sensorable/g935-electronics/pwr-conn/g935f-pwr.kicad_pcb

## KiCad design pwr-conn/g935f-pwr.kicad_pcb (2019-05-17)

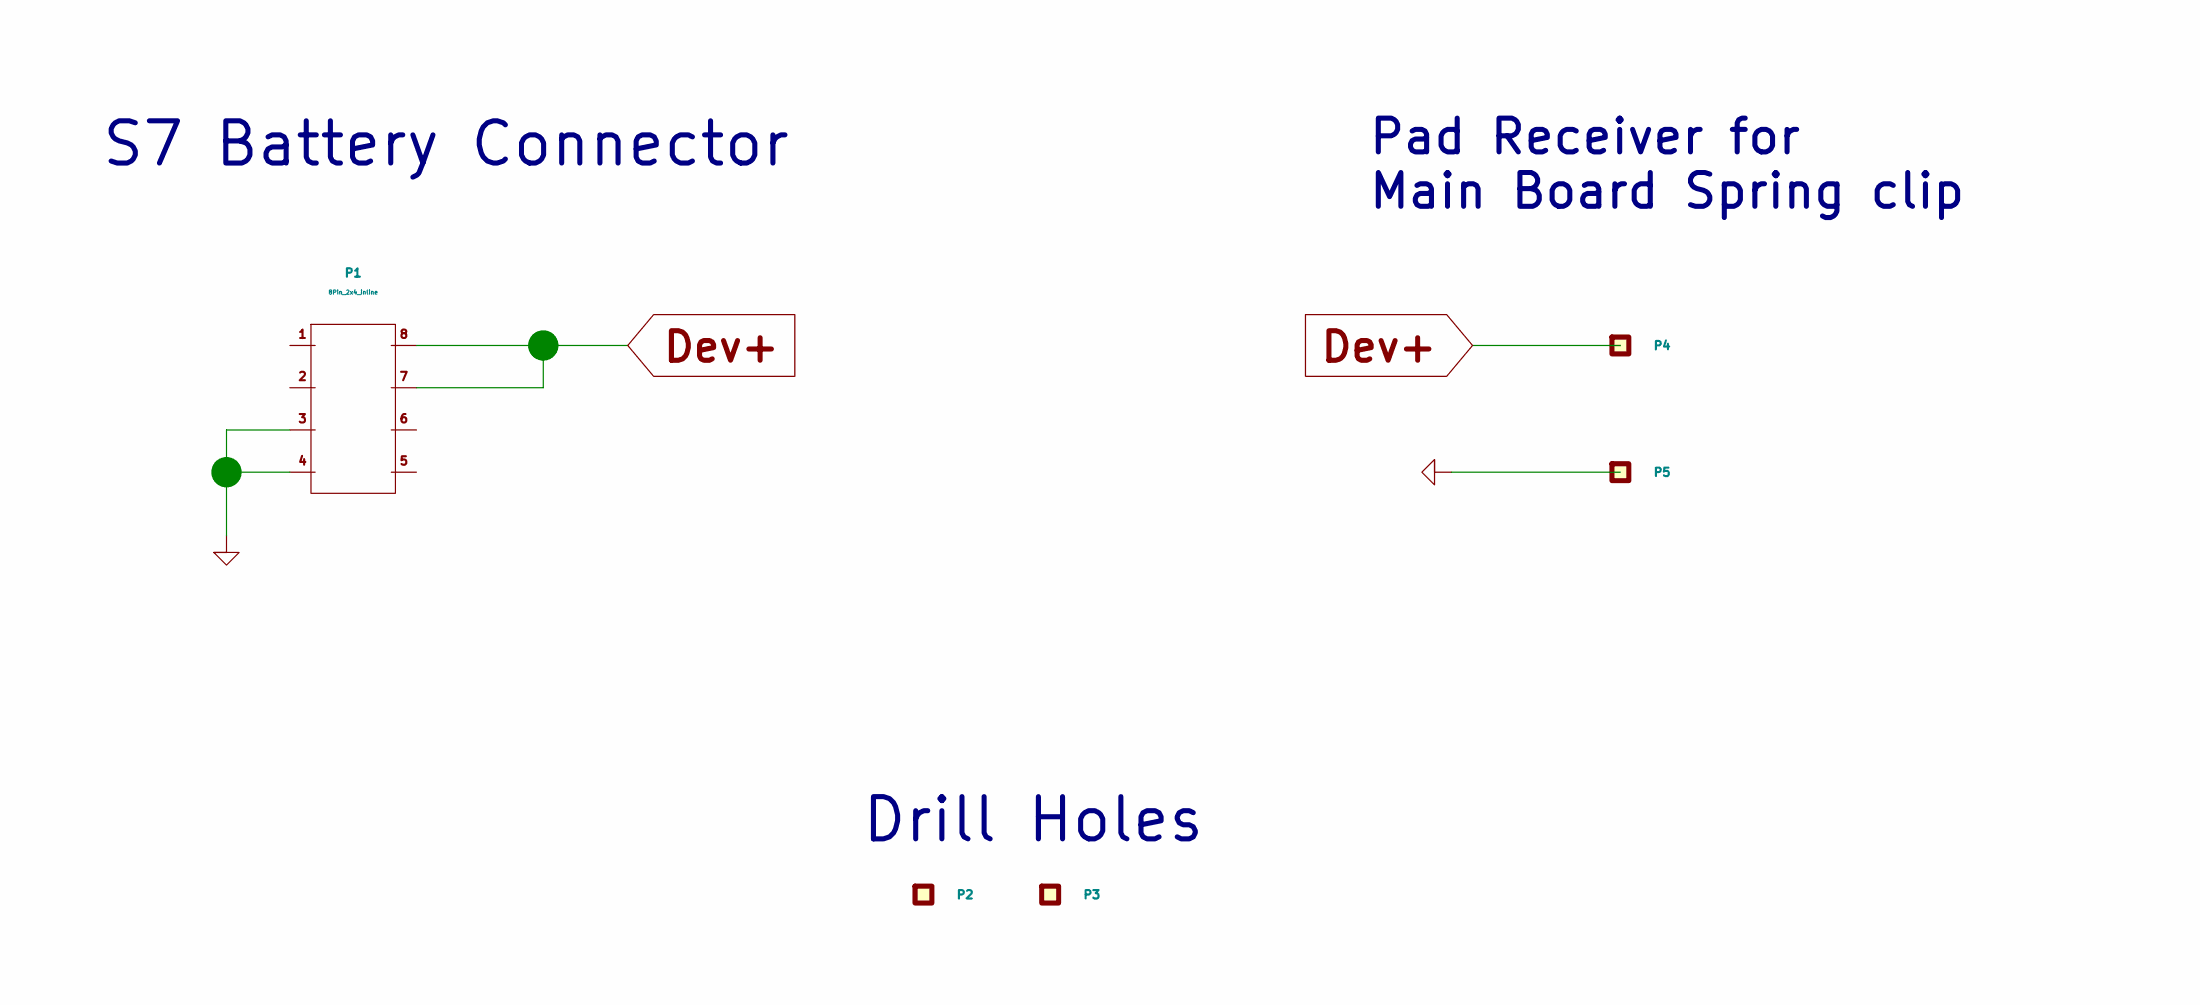
[picture p2: schematic g935f-pwr.sch]

Parts:
P1: 8Pin_2x4_inline; 8pin_molex_s7BatteryConn_5050040810; Manufacturer1PartNumber 5050040810
P2, P3: PAD; NPTH_1.5mm; Manufacturer1PartNumber MFG1PN
P4, P5: PAD; PAD_2.1mm_circle; Manufacturer1PartNumber MFG1PN

Connections:
Dev+: P1.7, P1.8, P4.1
GND1: P1.3, P1.4, P5.1

Notes on the sheet:
S7 Battery Connector
Drill Holes
Pad Receiver for Main Board Spring clip

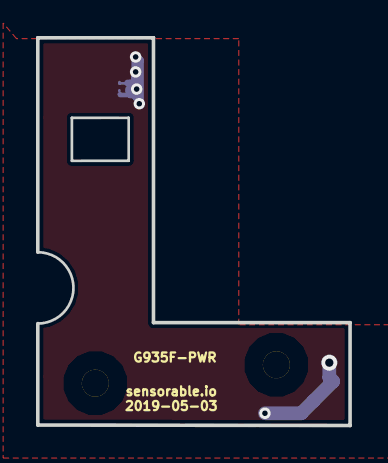
[picture p3: board g935f-pwr.kicad_pcb from above]

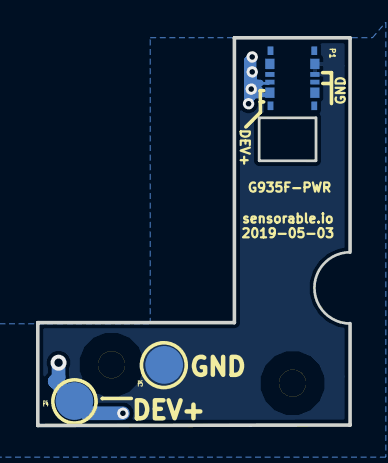
[picture p4: board g935f-pwr.kicad_pcb from below]

Board: 2 copper layers, 17.3 x 21.5 mm, 5 parts (3 on the bottom side), 2 nets.
