sensorable/g935-electronics/psu/g935f-psu.kicad_pcb

## KiCad design psu/g935f-psu.kicad_pcb (2019-05-03)

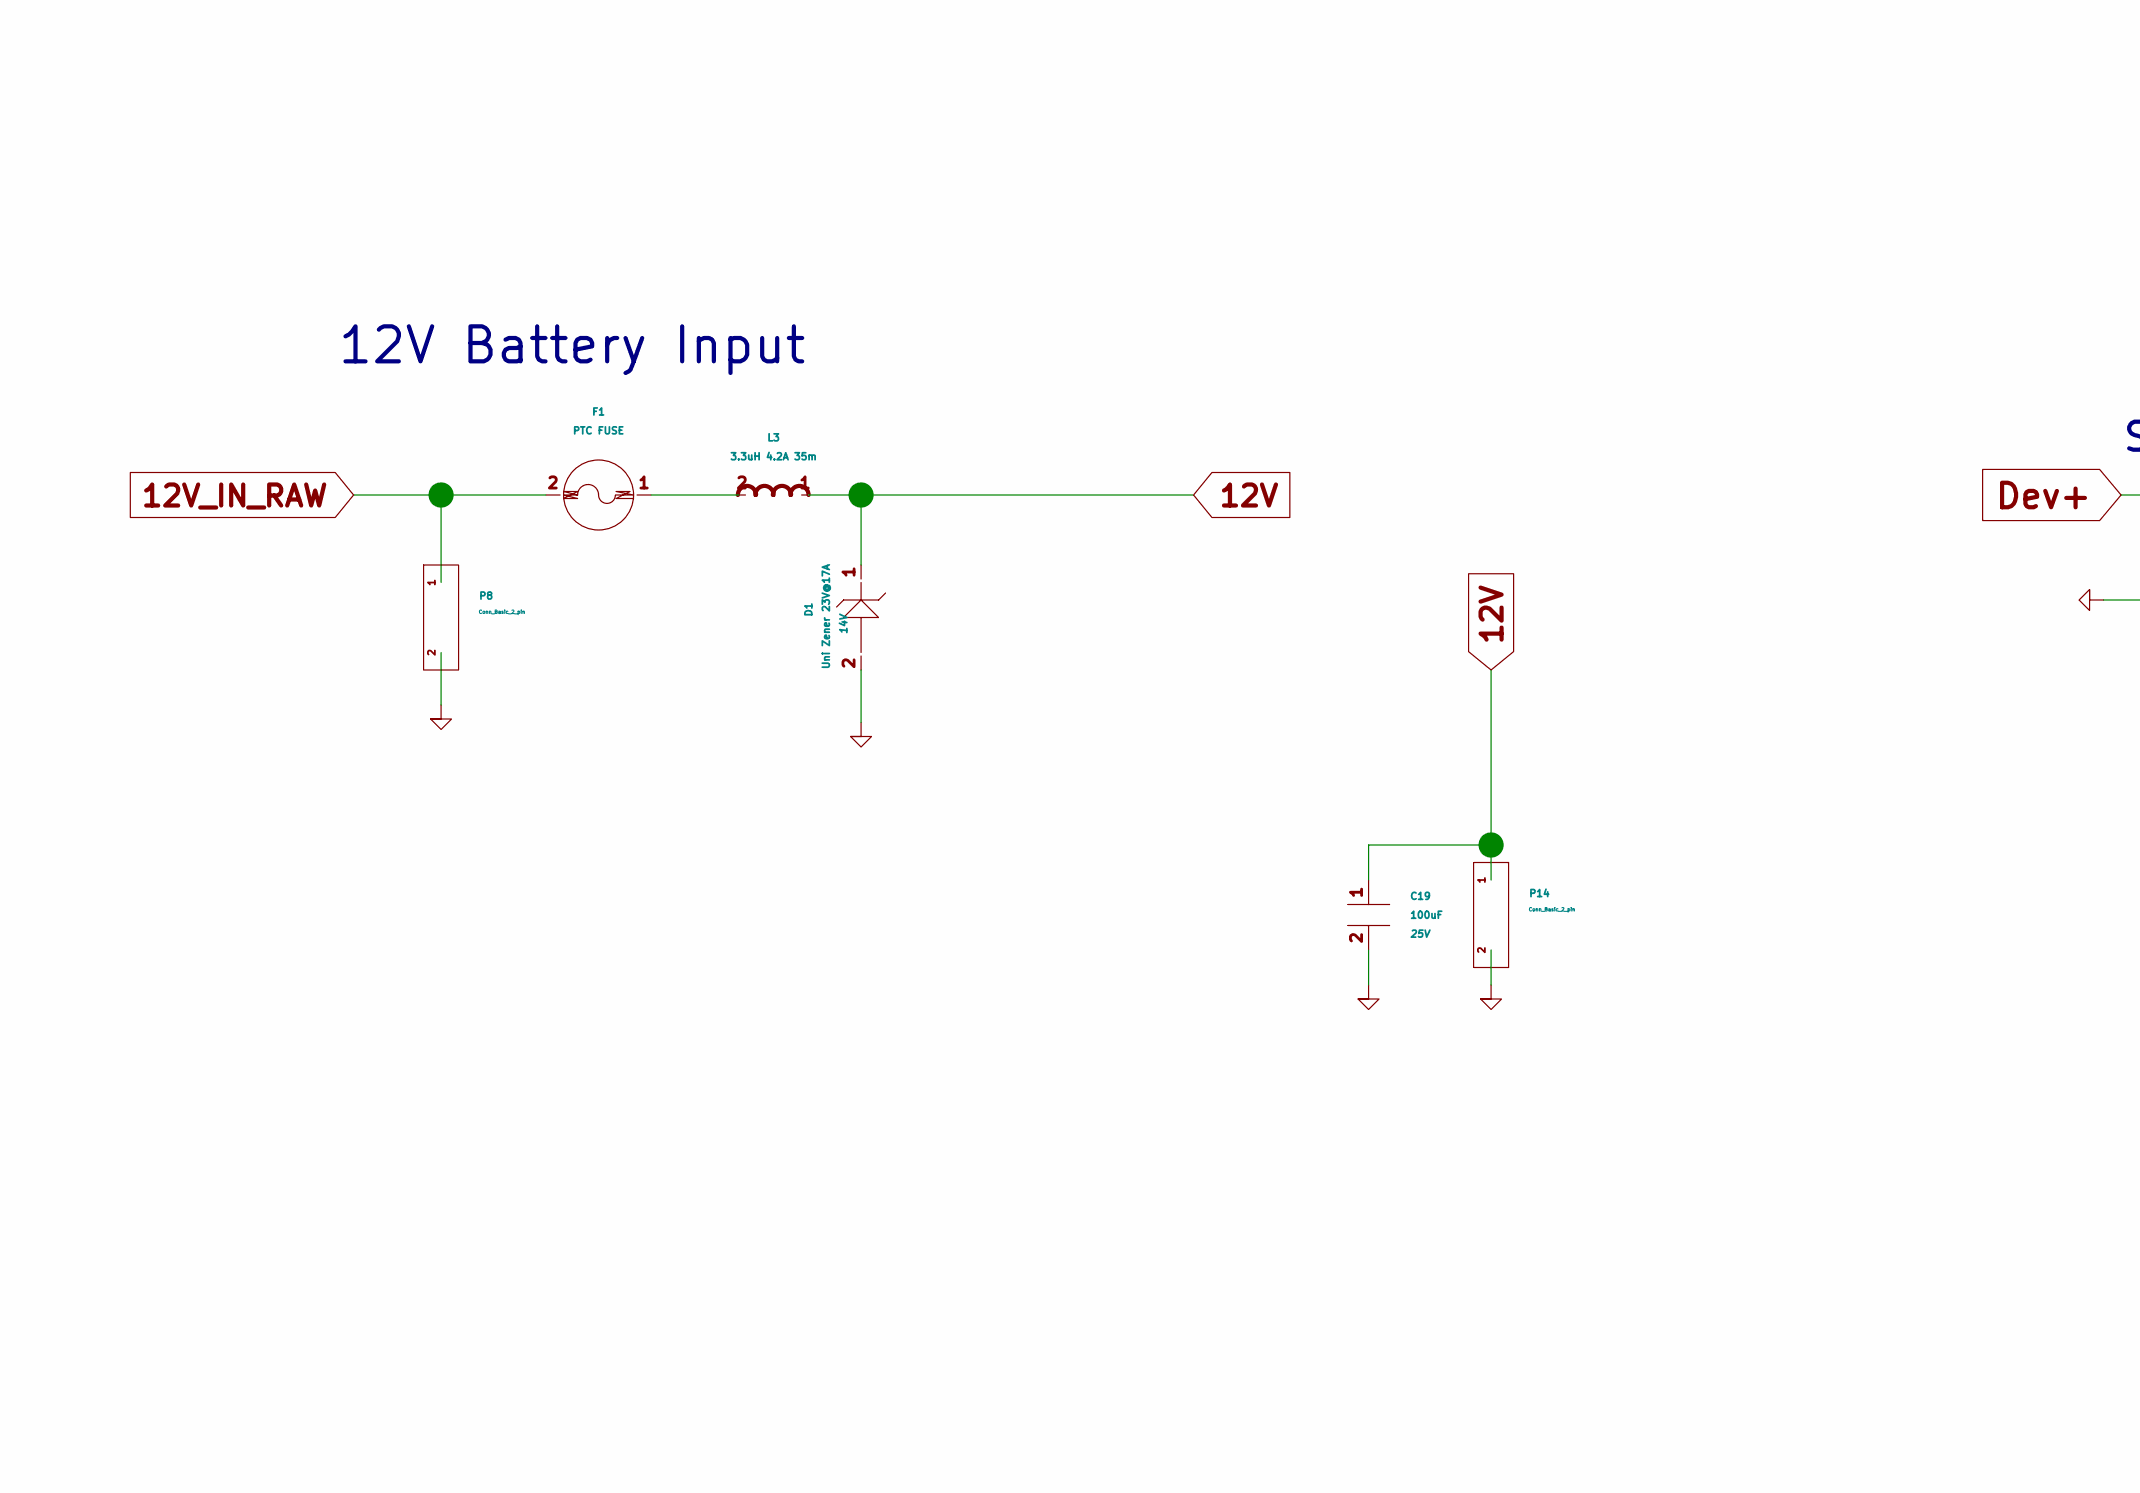
[picture p5: schematic g935f-psu.sch, TrafMaster, part in row 1, column 1]

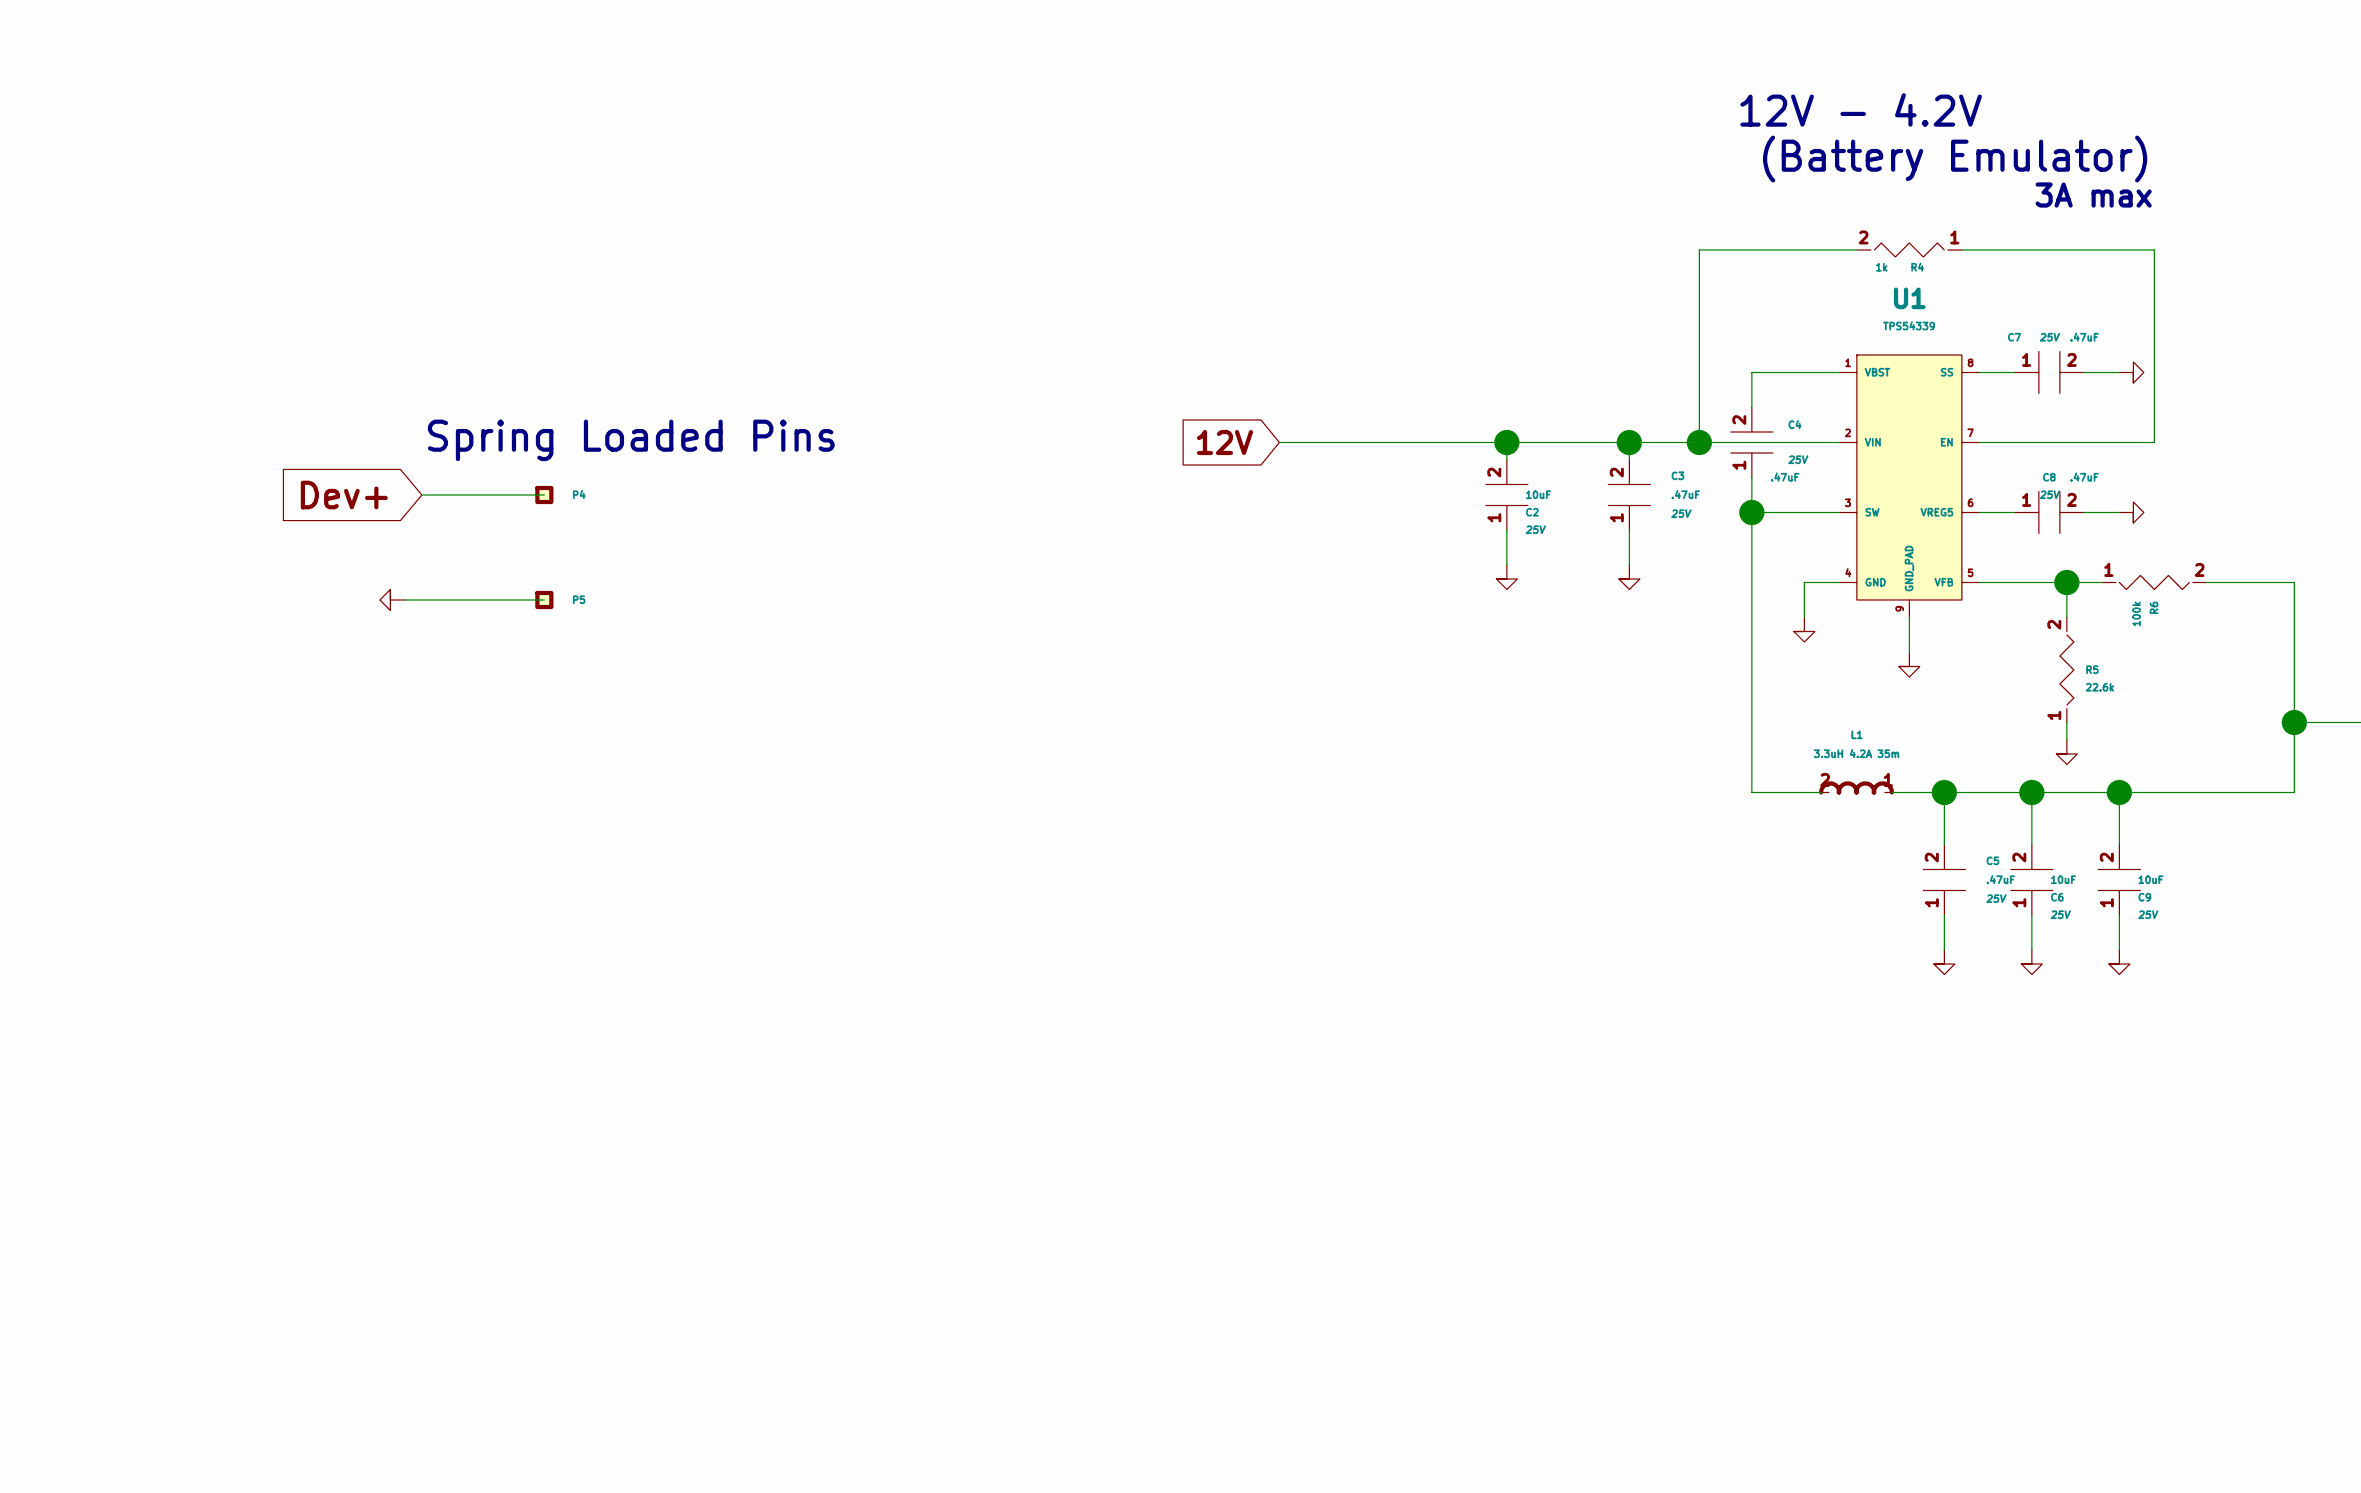
[picture p6: schematic g935f-psu.sch, TrafMaster, part in row 1, column 2]

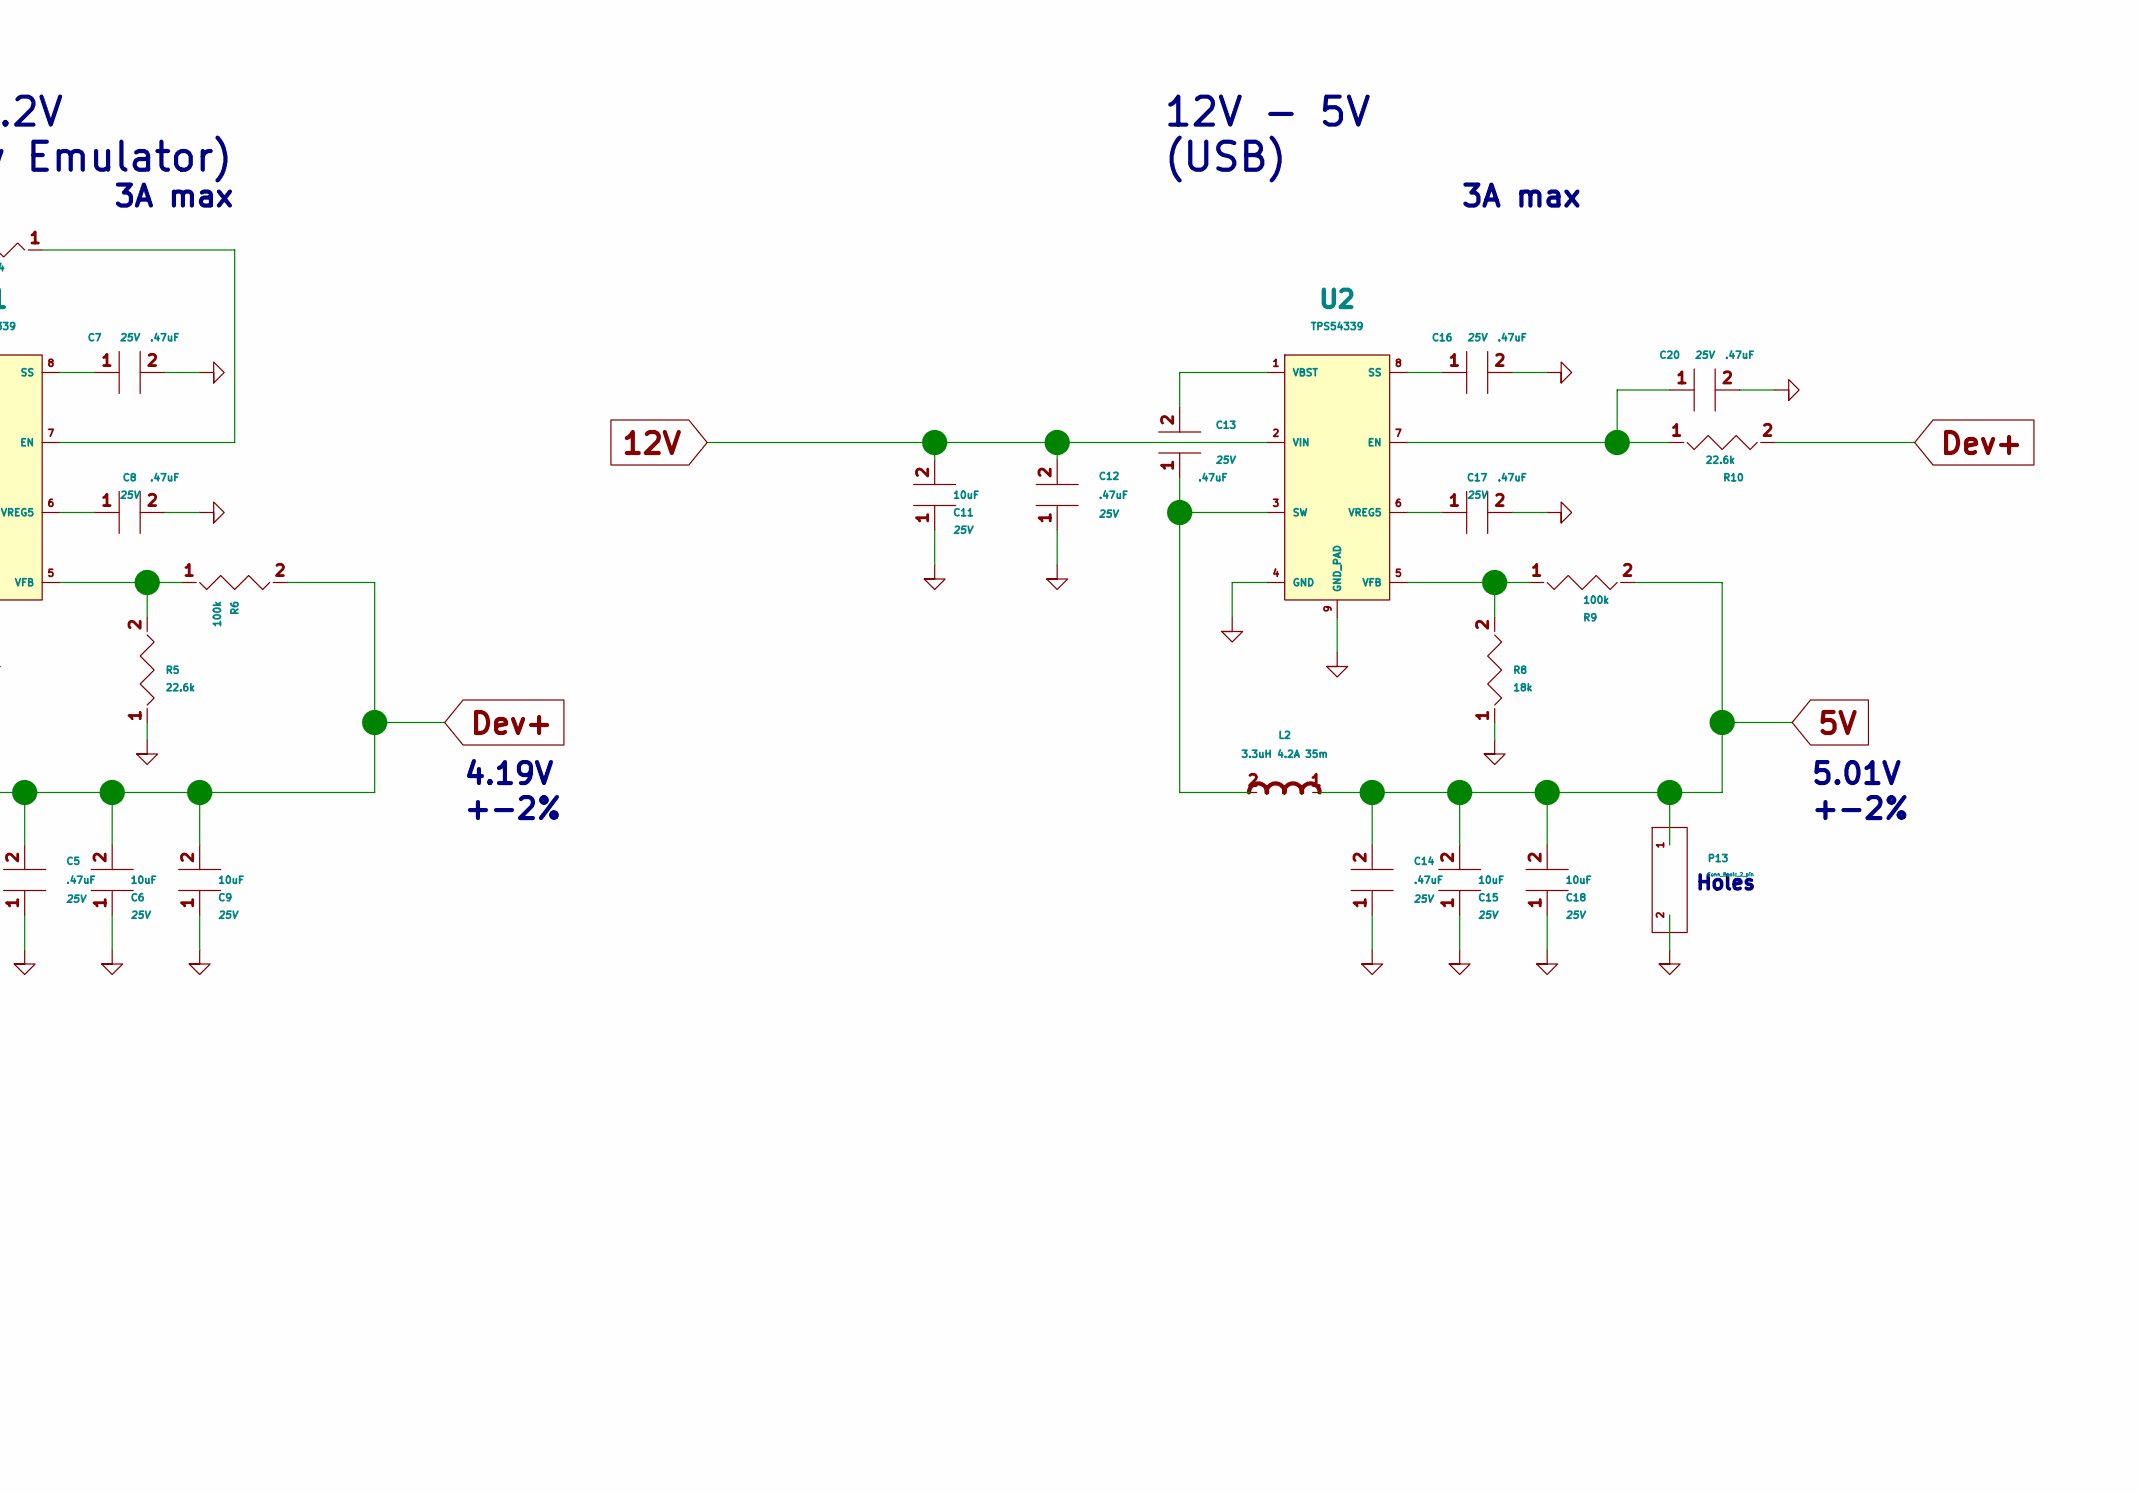
[picture p7: schematic g935f-psu.sch, TrafMaster, part in row 1, column 3]

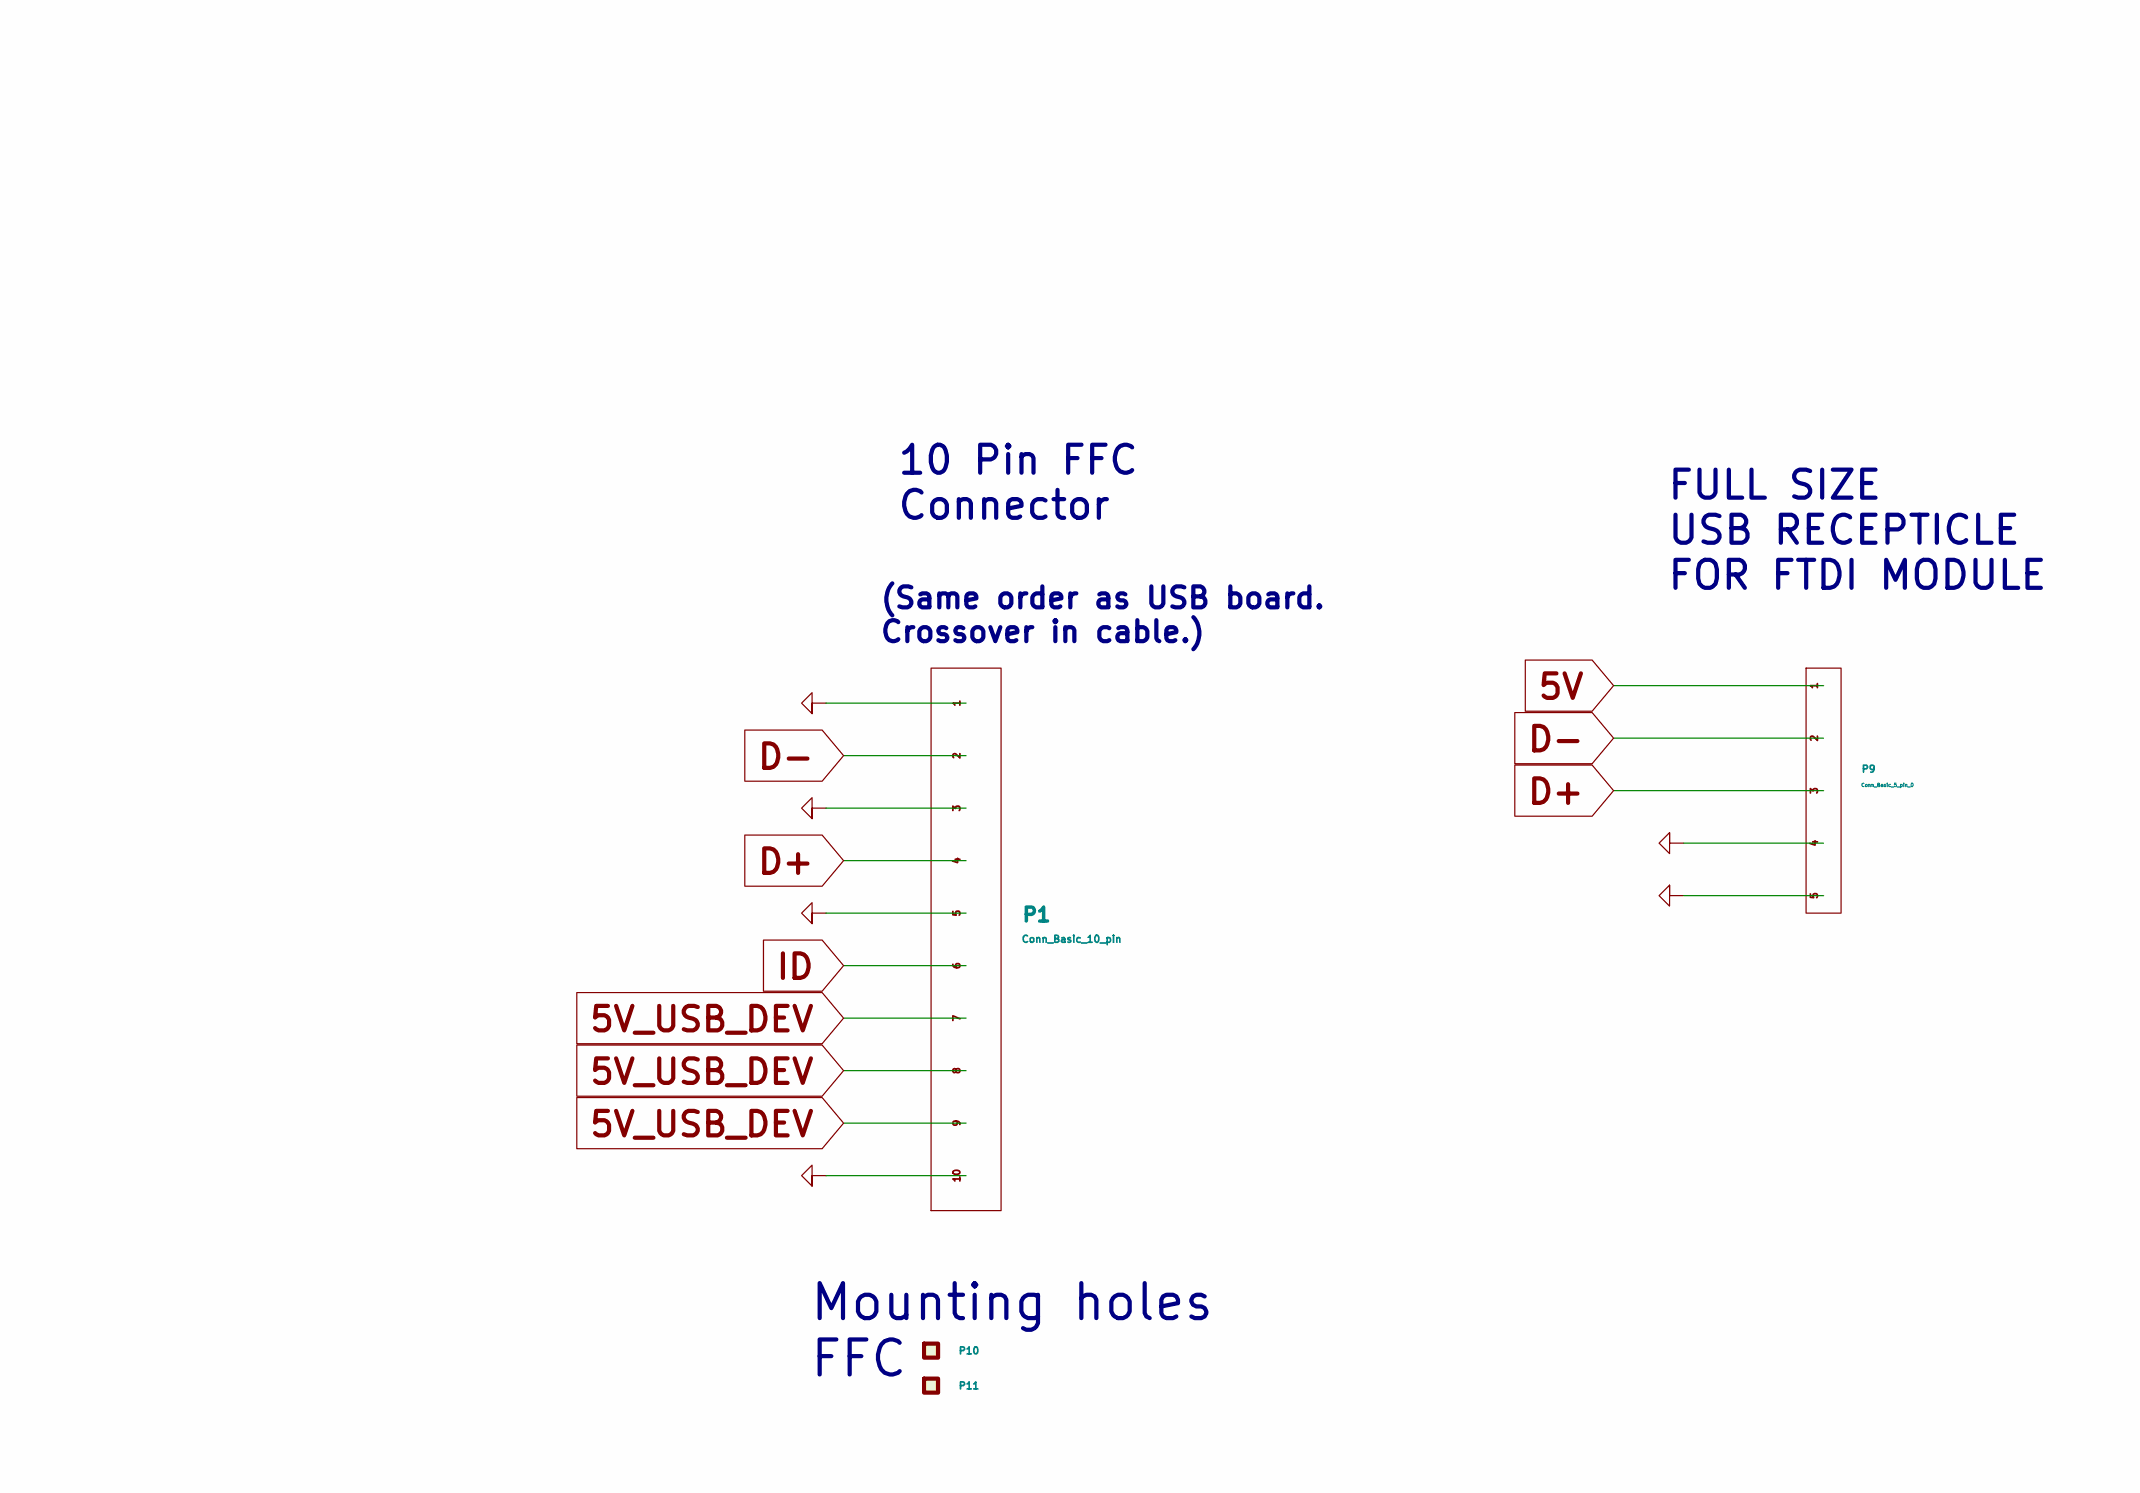
[picture p8: schematic g935f-psu.sch, TrafMaster, part in row 2, column 1]

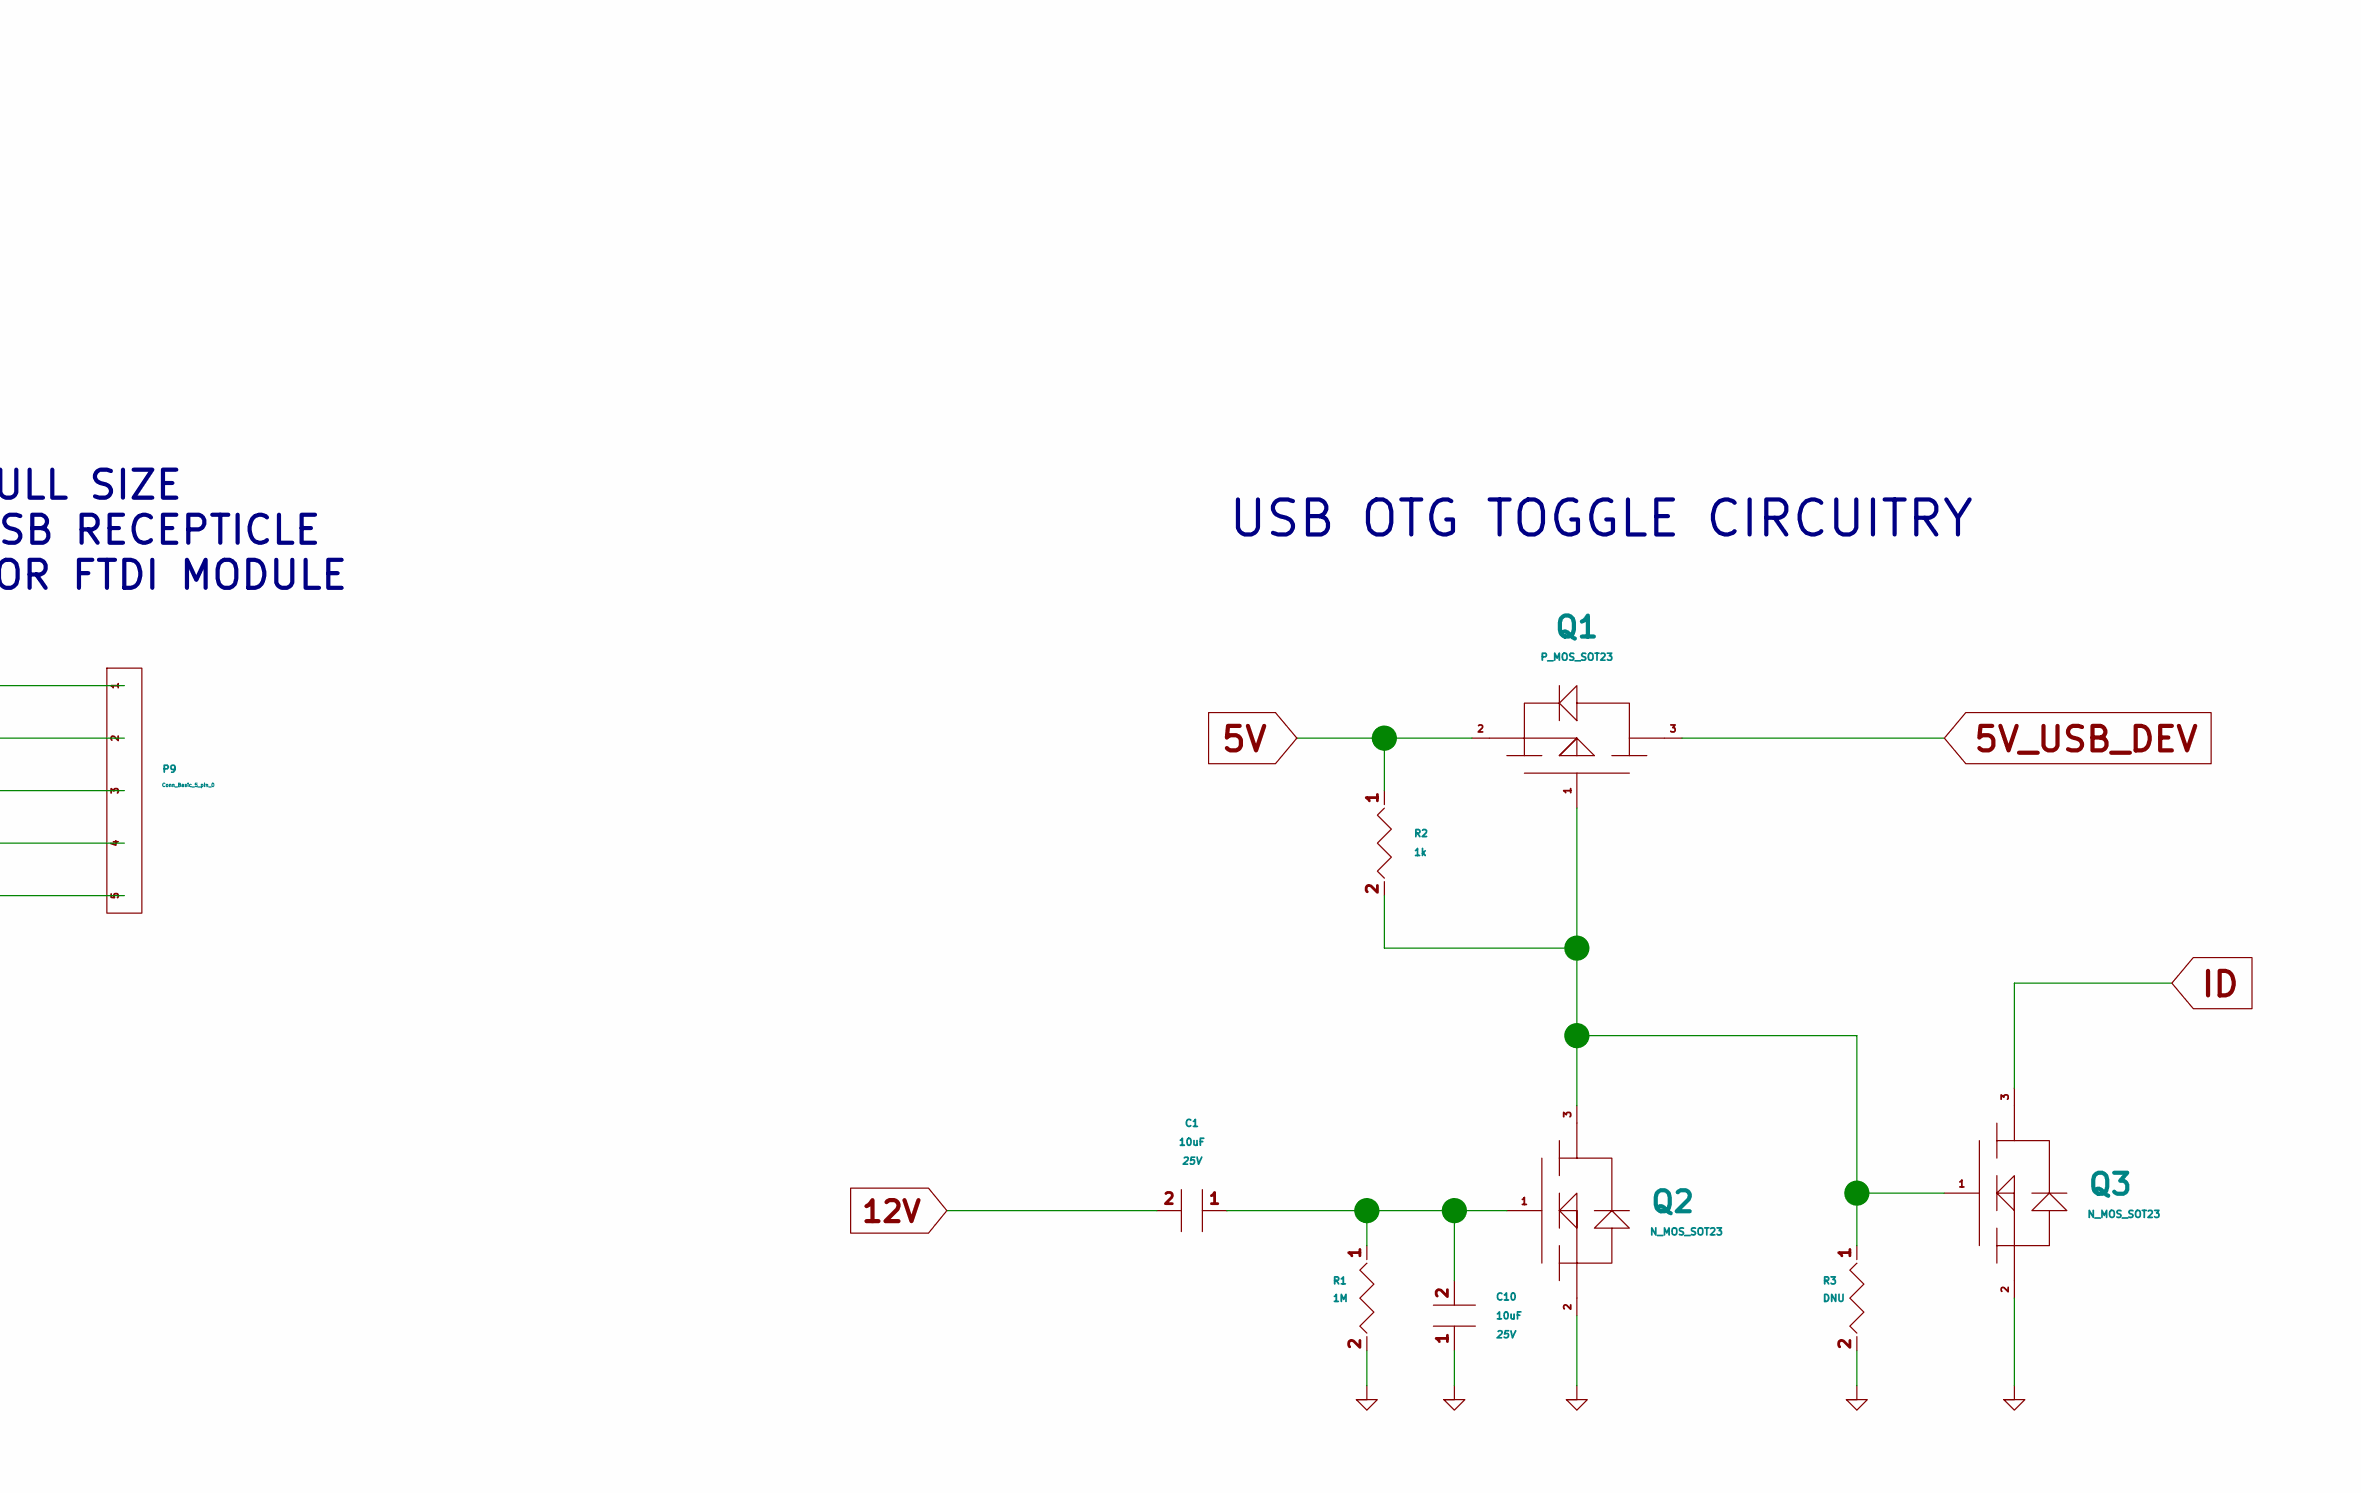
[picture p9: schematic g935f-psu.sch, TrafMaster, part in row 2, column 2]

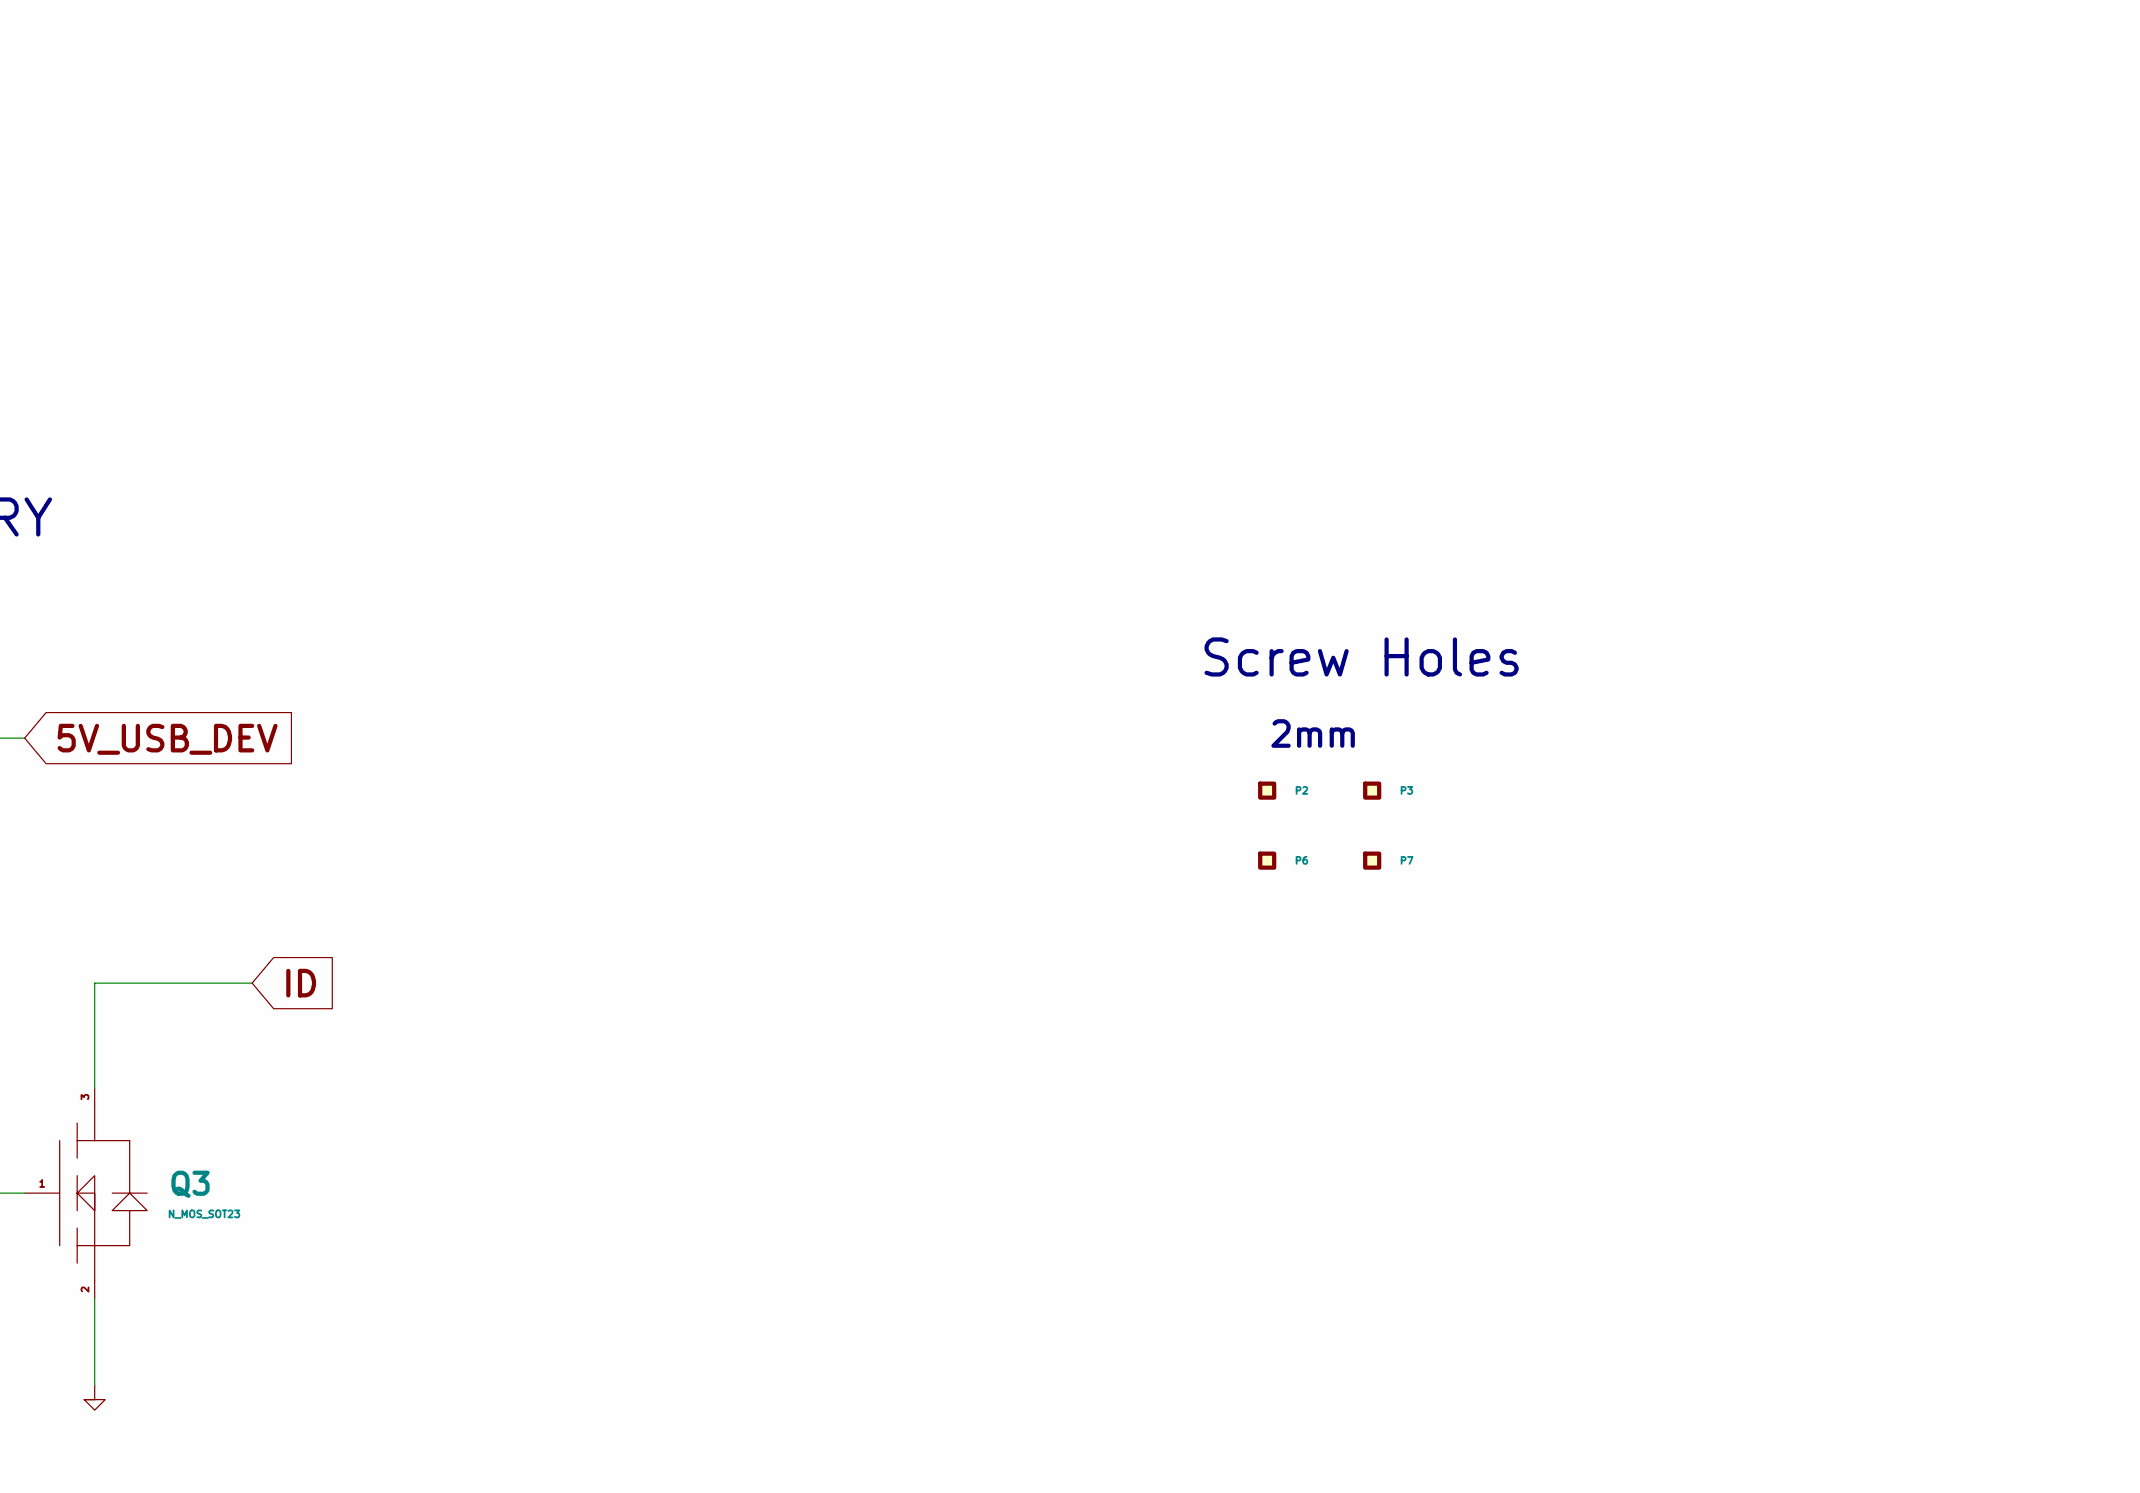
[picture p10: schematic g935f-psu.sch, TrafMaster, part in row 2, column 3]

Parts:
C1, C2, C6, C9, C10, C11, C15, C18: 10uF; 1206_Big-Pads; Voltage 25V; Manufacturer1PartNumber C3216X7R1E106K160AB
C3, C4, C5, C7, C8, C12, C13, C14, C16, C17, C20: .47uF; 0805_Medium_Pads; Voltage 25V; Manufacturer1PartNumber C0805C474K3RACTU
C19: 100uF; CAP_SMD_CAN_6.6x6.6mm; Voltage 25V; Manufacturer1PartNumber UWT1E101MCL1GS
D1: Uni Zener 23V@17A; SMA; Voltage 14V; Manufacturer1PartNumber SMAJ14A
F1: PTC FUSE; 1812; Tolerance Tol; Manufacturer1PartNumber 0ZCG0200AF2B
L1, L2, L3: 3.3uH 4.2A 35m; IND_2_5x5mm; Manufacturer1PartNumber VLS5045EX-3R3N
P1: Conn_Basic_10_pin; CONN_5034801000_MOLEX_FFC_10pin; Manufacturer1PartNumber 5034801000
P2, P3, P6, P7: PAD; NPTH_2mm; Manufacturer1PartNumber MFG1PN
P4, P5: PAD; CONN_1_SPRING_TH_1.83x.6mm; Manufacturer1PartNumber 0906-2-15-20-75-14-11-0
P8: Conn_Basic_2_pin; TERM_BLK_2_SIDE_2.54MM; Manufacturer1PartNumber 1725656
P9: Conn_Basic_5_pin_0; CONN_RCPT_USB2_TYPEA_RA_TE; Manufacturer1PartNumber 292303-9
P10, P11: PAD; NPTH_1.5mm; Manufacturer1PartNumber MFG1PN
P13, P14: Conn_Basic_2_pin; CONN_2pin_just_holes_2.54mmPITCH_1mmBigSquareHOLES; Manufacturer1PartNumber MFG1PN
Q1: P_MOS_SOT23; SOT-23; Manufacturer1PartNumber DMG2305UX-13
Q2, Q3: N_MOS_SOT23; SOT-23; Manufacturer1PartNumber DMN63D8L-7
R1: 1M; 0805_Medium_Pads; Tolerance 1%; Manufacturer1PartNumber RC0805FR-071ML
R2, R4: 1k; 0805_Medium_Pads; Tolerance Tol; Manufacturer1PartNumber RC0805FR-071KL
R3: DNU; 0805_Medium_Pads; Tolerance Tol; Manufacturer1PartNumber MFG1PN
R5, R10: 22.6k; 0805_Medium_Pads; Tolerance Tol; Manufacturer1PartNumber RC0805FR-0722K6L
R6, R9: 100k; 0805_Medium_Pads; Tolerance Tol; Manufacturer1PartNumber RC0805FR-07100KL
R8: 18k; 0805_Medium_Pads; Tolerance Tol; Manufacturer1PartNumber RC0805FR-0718KL
U1, U2: TPS54339; SOIC-8-1EP_3.9x4.9mm_Pitch1.27mm; Manufacturer1PartNumber TPS54339EDDAR

Connections:
5V: C14.2, C15.2, C18.2, L2.1, P9.1, P13.1, Q1.2, R2.1, R9.2
5V_USB_DEV: P1.7, P1.8, P1.9, Q1.3
12V: C1.2, C2.2, C3.2, C11.2, C12.2, C19.1, D1.1, L3.1, P14.1, R4.2, U1.2 (VIN), U2.2 (VIN)
12V_IN_RAW: F1.2, P8.1
D+: P1.4, P9.3
D-: P1.2, P9.2
Dev+: C5.2, C6.2, C9.2, L1.1, P4.1, R6.2, R10.2
GND1: C2.1, C3.1, C5.1, C6.1, C7.2, C8.2, C9.1, C10.1, C11.1, C12.1, C14.1, C15.1, C16.2, C17.2, C18.1, C19.2, C20.2, D1.2, P1.1, P1.3, P1.5, P1.10, P5.1, P8.2, P9.4, P9.5, P13.2, P14.2, Q2.2, Q3.2, R1.2, R3.2, R5.1, R8.1, U1.4 (GND), U1.9 (GND_PAD), U2.4 (GND), U2.9 (GND_PAD)
ID: P1.6, Q3.3
unnamed: C1.1, C10.2, Q2.1, R1.1
unnamed: C4.1, L1.2, U1.3 (SW)
unnamed: C4.2, U1.1 (VBST)
unnamed: C7.1, U1.8 (SS)
unnamed: C8.1, U1.6 (VREG5)
unnamed: C13.1, L2.2, U2.3 (SW)
unnamed: C13.2, U2.1 (VBST)
unnamed: C16.1, U2.8 (SS)
unnamed: C17.1, U2.6 (VREG5)
unnamed: C20.1, R10.1, U2.7 (EN)
unnamed: F1.1, L3.2
unnamed: Q1.1, Q2.3, Q3.1, R2.2, R3.1
unnamed: R4.1, U1.7 (EN)
unnamed: R5.2, R6.1, U1.5 (VFB)
unnamed: R8.2, R9.1, U2.5 (VFB)

Notes on the sheet:
Screw Holes
Spring Loaded Pins
2mm
10 Pin FFC Connector
(Same order as USB board. Crossover in cable.)
12V Battery Input
FULL SIZE USB RECEPTICLE FOR FTDI MODULE
USB OTG TOGGLE CIRCUITRY
Mounting holes FFC
4.19V
12V - 4.2V (Battery Emulator)
3A max
Holes
5.01V
12V - 5V (USB)
+-2%

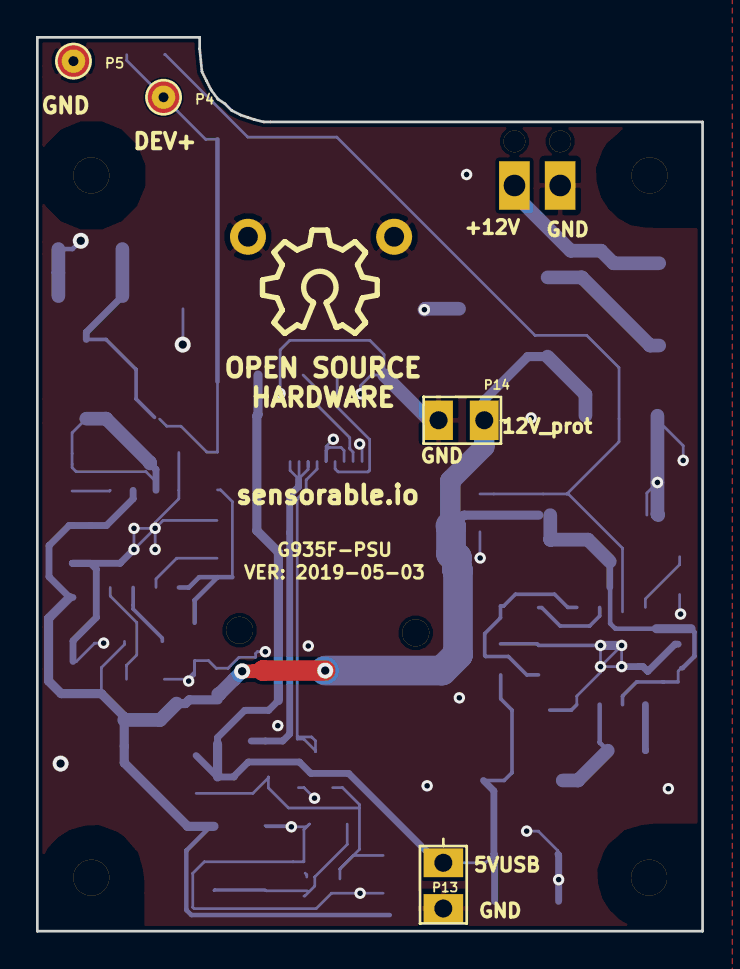
[picture p11: board g935f-psu.kicad_pcb from above]

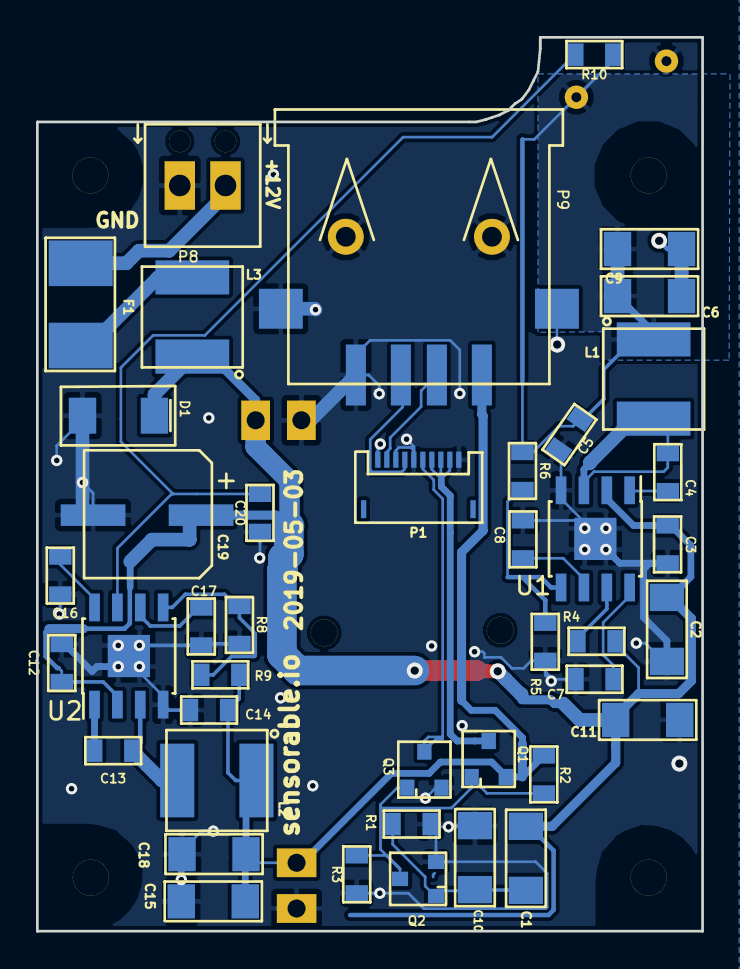
[picture p12: board g935f-psu.kicad_pcb from below]

Board: 2 copper layers, 37.0 x 49.7 mm, 52 parts (42 on the bottom side), 24 nets.
